micahyy/czmao_WCH/hardware/case/output/print_top.dxf

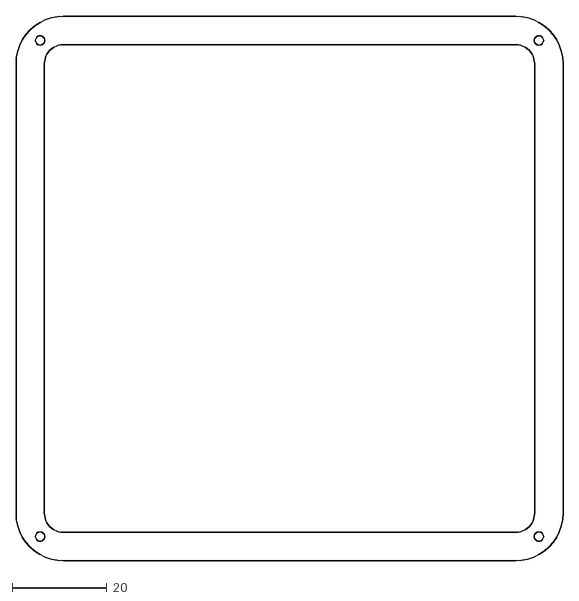
[picture p1: CAD file, 2026-11-12]
hardware/case/output/print_top.dxf
115.7 x 115.2
