micahyy/czmao_WCH/hardware/case/output/cnc_plate.dxf

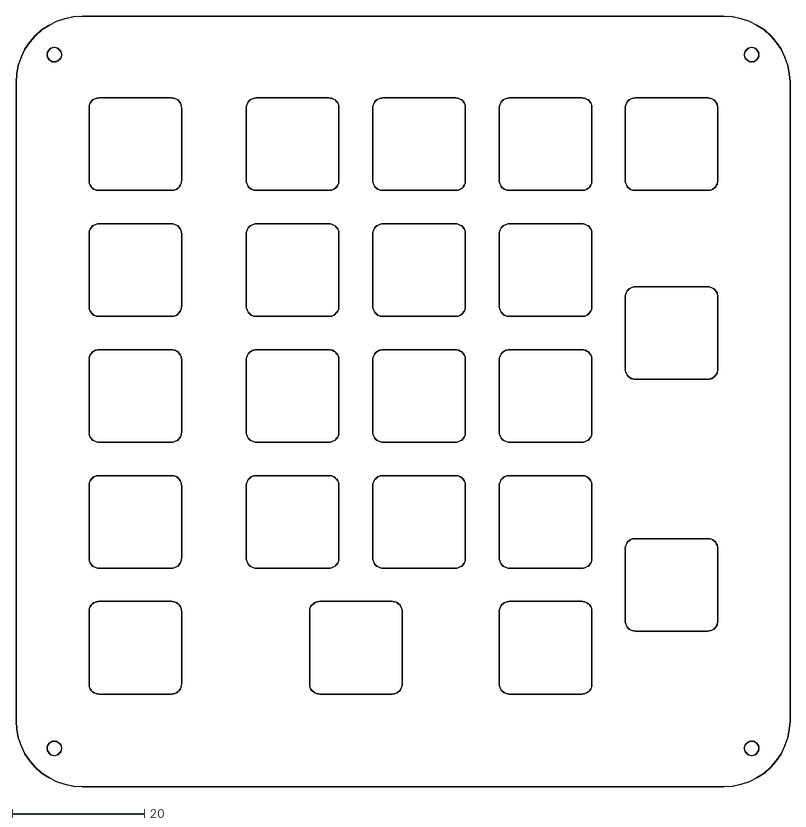
[picture p2: CAD file, 2026-11-12]
hardware/case/output/cnc_plate.dxf
117.1 x 116.6
