micahyy/czmao_WCH/hardware/case/output/cnc_top.dxf

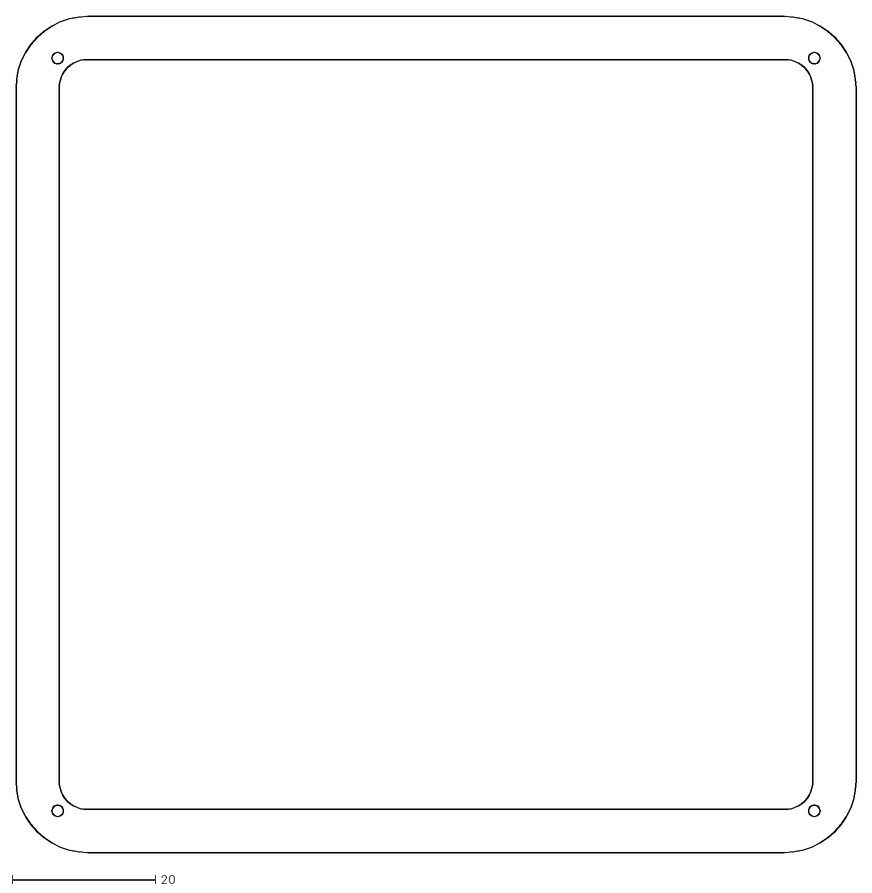
[picture p3: CAD file, 2026-11-12]
hardware/case/output/cnc_top.dxf
117.1 x 116.6
