micahyy/czmao_WCH/hardware/case/output/print_plate.dxf

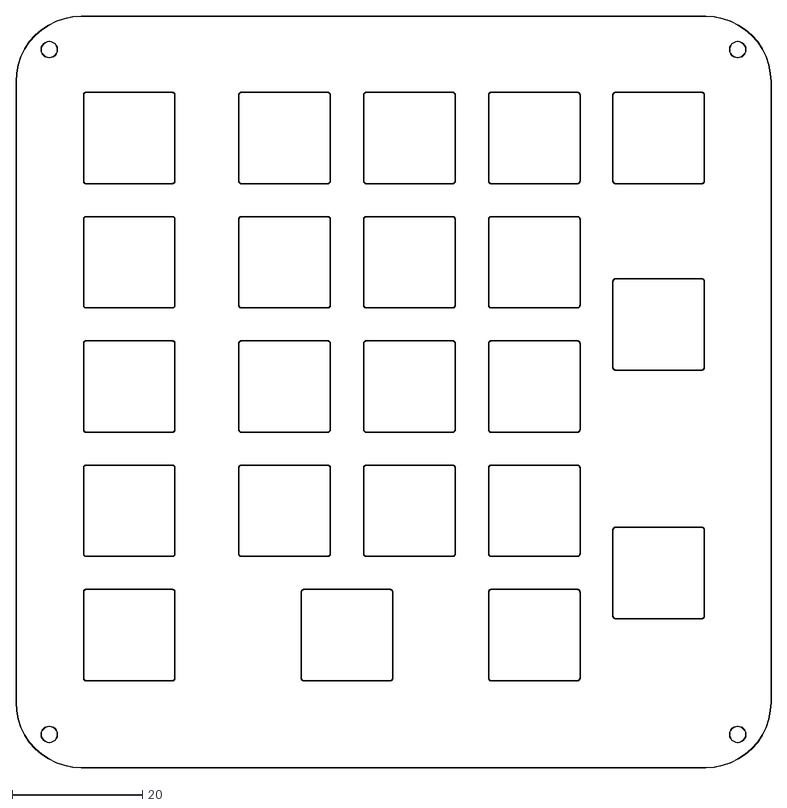
[picture p4: CAD file, 2026-11-12]
hardware/case/output/print_plate.dxf
115.7 x 115.2
