micahyy/czmao_WCH/hardware/pcb/board_data.scad

// 由 tools/extract_step.py 从 STEP 自动提取，勿手工编辑

// 坐标 = STEP 原始坐标(mm)，原点在 PCB 左下角附近；+Y 边是 USB-C 侧

board_t = 1.6000;
board_cx = 49.5301; board_cy = 51.5247;
board_w = 98.5268; board_h = 97.9735;
usb_x = 49.8829; usb_y = 95.7908;
board_poly = [[2.5934,95.2364],[42.4120,95.2375],[42.7620,95.2714],[43.0987,95.3729],[43.4091,95.5381],[43.6813,95.7607],[43.9048,96.0322],[44.0711,96.3420],[44.1737,96.6783],[44.2088,97.0282],[44.2088,100.0762],[44.2172,100.1611],[44.2419,100.2428],[44.2821,100.3180],[44.3363,100.3840],[44.4022,100.4381],[44.4775,100.4784],[44.5592,100.5031],[44.6441,100.5115],[55.3718,100.5115],[55.4685,100.5020],[55.5615,100.4738],[55.6471,100.4280],[55.7222,100.3663],[55.7839,100.2912],[55.8297,100.2055],[55.8579,100.1126],[55.8674,100.0159],[55.8674,97.0282],[55.9018,96.6786],[56.0038,96.3425],[56.1694,96.0328],[56.3922,95.7612],[56.6637,95.5384],[56.9735,95.3728],[57.3096,95.2709],[57.6592,95.2364],[97.0292,95.2364],[97.3734,95.2025],[97.7044,95.1022],[98.0094,94.9391],[98.2768,94.7197],[98.4962,94.4524],[98.6592,94.1473],[98.7596,93.8164],[98.7935,93.4722],[98.7935,2.5380],[0.2667,2.5380],[0.2667,92.9097],[0.3114,93.3636],[0.4438,93.8001],[0.6588,94.2024],[0.9482,94.5550],[1.3008,94.8443],[1.7030,95.0593],[2.1395,95.1917]];
switch_xy = [[9.0170,90.4615],[32.8296,90.4615],[51.9749,90.4615],[71.1201,90.4615],[90.1702,90.4615],[9.0170,71.4114],[32.8296,71.4114],[51.9749,71.4114],[71.1201,71.4114],[90.1702,61.8864],[9.0170,52.3614],[32.8296,52.3614],[51.9749,52.3614],[71.1201,52.3614],[9.0170,33.3114],[32.8294,33.3113],[51.9748,33.3113],[71.1201,33.3113],[90.1702,23.7863],[9.0170,14.2613],[42.4021,14.2613],[71.1201,14.2613]];
switch_refs = ["ESC","NUM","P/","P*","P-","HOME","P7","P8","P9","P+","PGUP","P4","P5","P6","PGDN","P1","P2","P3","PENT","FN","P0","PDOT"];
pcb_holes = [[4.445,9.525,0.840],[4.445,28.575,0.840],[4.445,47.625,0.840],[4.445,66.675,0.840],[4.445,85.725,0.840],[5.715,12.065,1.481],[5.715,31.115,1.481],[5.715,50.165,1.481],[5.715,69.215,1.481],[5.715,88.265,1.481],[9.487,4.488,1.903],[9.487,23.538,1.903],[9.487,42.588,1.903],[9.487,61.638,1.903],[9.487,80.688,1.903],[9.525,9.525,2.069],[9.525,28.575,2.069],[9.525,47.625,2.069],[9.525,66.675,2.069],[9.525,85.725,2.069],[12.065,14.605,1.481],[12.065,33.655,1.481],[12.065,52.705,1.481],[12.065,71.755,1.481],[12.065,90.805,1.481],[14.605,9.525,0.840],[14.605,28.575,0.840],[14.605,47.625,0.840],[14.605,66.675,0.840],[14.605,85.725,0.840],[28.257,28.575,0.840],[28.258,47.625,0.840],[28.258,66.675,0.840],[28.258,85.725,0.840],[29.527,31.115,1.481],[29.528,50.165,1.481],[29.528,69.215,1.481],[29.528,88.265,1.481],[33.299,23.538,1.903],[33.299,42.588,1.903],[33.299,61.638,1.903],[33.299,80.688,1.903],[33.337,28.575,2.069],[33.338,47.625,2.069],[33.338,66.675,2.069],[33.338,85.725,2.069],[35.877,33.655,1.481],[35.878,52.705,1.481],[35.878,71.755,1.481],[35.878,90.805,1.481],[37.830,9.525,0.840],[38.417,28.575,0.840],[38.418,47.625,0.840],[38.418,66.675,0.840],[38.418,85.725,0.840],[39.100,12.065,1.481],[42.910,9.525,2.069],[43.000,4.488,1.903],[45.450,14.605,1.481],[47.403,28.575,0.840],[47.403,47.625,0.840],[47.403,66.675,0.840],[47.403,85.725,0.840],[47.990,9.525,0.840],[48.673,31.115,1.481],[48.673,50.165,1.481],[48.673,69.215,1.481],[48.673,88.265,1.481],[52.413,23.538,1.903],[52.413,42.588,1.903],[52.413,61.638,1.903],[52.446,80.688,1.903],[52.483,28.575,2.069],[52.483,47.625,2.069],[52.483,66.675,2.069],[52.483,85.725,2.069],[55.023,33.655,1.481],[55.023,52.705,1.481],[55.023,71.755,1.481],[55.023,90.805,1.481],[57.563,28.575,0.840],[57.563,47.625,0.840],[57.563,66.675,0.840],[57.563,85.725,0.840],[66.548,9.525,0.840],[66.548,28.575,0.840],[66.548,47.625,0.840],[66.548,66.675,0.840],[66.548,85.725,0.840],[67.818,12.065,1.481],[67.818,31.115,1.481],[67.818,50.165,1.481],[67.818,69.215,1.481],[67.818,88.265,1.481],[71.590,4.488,1.903],[71.590,23.538,1.903],[71.590,42.588,1.903],[71.590,61.638,1.903],[71.590,80.688,1.903],[71.628,9.525,2.069],[71.628,28.575,2.069],[71.628,47.625,2.069],[71.628,66.675,2.069],[71.628,85.725,2.069],[74.168,14.605,1.481],[74.168,33.655,1.481],[74.168,52.705,1.481],[74.168,71.755,1.481],[74.168,90.805,1.481],[76.708,9.525,0.840],[76.708,28.575,0.840],[76.708,47.625,0.840],[76.708,66.675,0.840],[76.708,85.725,0.840],[85.598,19.050,0.840],[85.598,57.150,0.840],[85.598,85.725,0.840],[86.868,21.590,1.481],[86.868,59.690,1.481],[86.868,88.265,1.481],[90.640,52.113,1.903],[90.640,80.688,1.903],[90.678,13.970,1.903],[90.678,19.050,2.069],[90.678,57.150,2.069],[90.678,85.725,2.069],[93.218,24.130,1.481],[93.218,62.230,1.481],[93.218,90.805,1.481],[95.758,19.050,0.840],[95.758,57.150,0.840],[95.758,85.725,0.840]];
