micahyy/czmao_WCH/hardware/pcb/ch552g_22key/config_ch552t.h

#pragma once
/* ============================================================================
 * CH552T (TSSOP20) x 22 键 numpad —— IO 分配 v0.1  [备选方案]
 *
 * 与同目录 config.h (CH552G/SOP16) 二选一：把选中的文件复制成
 * keyboards/<你的板>/config.h 即可。两份 DIODE_DIRECTION 都是 COL2ROW，
 * 但 ROW/COL 引脚宏不同（G 版 10 个 GPIO、T 版 14 个），别混用。
 *
 * ⚠ 档案状态（19:44 更新）：本文件是 11-08 下单前的硬件推理链，**不参与编译**。
 *   最终出货配置在 ../../firmware/keyboards/DS22Lite/config.h：
 *   VID 0x5262 / PID 0x4443，USB 产品串 DS22Lite；
 *   砍掉宏 + TAP_DANCE + FCODE_TO_MOUSE；2 层动态（VIA 可改）+ 2 层静态
 *   （Flash 常量，VIA 看不到）共 4 套键位；DataFlash 只用 106B / 128B，
 *   VIA_MAGIC_CODE = 0x5C。
 *   本文件里遗留的单层、VID 0xFEED、Tap Dance、17B 宏分区等结论均已作废。
 *
 * 为什么有这份：老板进货价 CH552G ¥1.57 / CH552T ¥1.75，差价仅 ¥0.18。
 * 为省 0.18 去把 RST 改造成矩阵输入（要改 framework 三处 + 加外部上拉 +
 * 守 En_RST_RESET 产线红线）不划算，直接换 T 版是零固件改动。
 *
 * ★ 20:07 已按 Netlist_DS22Lite_R1.0.0 全量同步（老板「下单」）：
 *   ROW = {P3.3,P3.4,P3.5,P1.3,P1.2} / COL = {P3.2,P1.4,P1.5,P1.6,P1.7}，
 *   灯 2812_PWM = P1.0，P3.0/P3.1/P1.1 空置，板上无编码器 → 编码器宏已关。
 *   BAT54C 共阴极接 ROW → DIODE_DIRECTION = COL2ROW（行输出拉低、列输入上拉）。
 *   keymap.h 两层键表 / RGB_CONFIG / DS22Lite_via.json 的 (r,c) 已同步重排。
 *   旧的 RP17 基线（灯 P3.5、编码器 P1.2/P1.3）与 19:08 TODO 警告一并作废。
 *
 * 引脚编号规则（沿用框架）：两位数 = 端口*10 + 位号
 *   32 = P3.2    14 = P1.4    35 = P3.5    10 = P1.0    12 = P1.2 ...
 *
 * ---------------------------------------------------------------------------
 * TSSOP20 引脚（WCH CH552DS1 第 4 节 / LCSC C111367）
 *
 *  pin   PORT        用途              备注
 *   1    P3.2        COL0              BAT54C 阳极侧，芯片直连
 *   2    P1.4        COL1
 *   3    P1.5        COL2              G 版同一端口
 *   4    P1.6        COL3
 *   5    P1.7        COL4
 *   6    RST         NC                彻底不引出，见清单第 8 条
 *   7    P1.0        WS2812 DI         ★ 20:07 改：网表 2812_PWM
 *   8    P1.1        空置               G 版在 pin9 作 ROW4
 *   9    P3.1        空置               G 版在 pin7 作 COL1
 *  10    P3.0        空置               G 版在 pin8 作 COL0
 *  11    P3.3        ROW0              BAT54C 共阴极侧
 *  12    P3.4        ROW1
 *  13    P3.5        ROW2              ★ T 版新增（G 版未引出）
 *  14    P3.6 / UDP  D+                USB 专用，不可占用
 *  15    P3.7 / UDM  D-                USB 专用，不可占用
 *  16    P1.3 / XO   ROW3              ★ 不接晶振才有此脚
 *  17    P1.2 / XI   ROW4              ★ 不接晶振才有此脚
 *  18    GND         --                G 版在 pin14
 *  19    VCC         5V                烧录 Flash 必须 5V；G 版在 pin15
 *  20    V33         3.3V              内置 LDO 输出，必须 100nF 去耦，禁与 VCC 短接
 *
 *  ★ 20:07 更正：DS22Lite 的 ROW/COL 网络与 RP17 基线**不是同一组端口**
 *    （不只是封装脚号重排），矩阵宏必须按网表整组换，见下方矩阵块。
 *
 *  GPIO 账（不接晶振）：P1 八位 + P3 八位 = 16，减 USB 的 P3.6/P3.7 = 14。
 *    矩阵 5+5 = 10  +  WS2812 1 = 11，剩 P3.0/P3.1/P1.1 三个空置。
 *    板上没有编码器，P1.2/P1.3 已改作 ROW4/ROW3。
 *    一旦在 XI/XO 上接晶振，P1.2/P1.3 就没了，掉回 12 个 IO（本板不接）。
 * ==========================================================================*/

#define VENDOR_ID   0xFEED    // QMK 社区通用占位 VID；出货前换自己的，DS22Lite_via.json 必须同步
#define PRODUCT_ID  0x0016    // 同一 VID 下不可重复；出货前确认未占用
#define MANUFACTURER 'M','a','i','k','u'   // TODO 出货前确认品牌字符串
#define PRODUCT      'D','S','2','2','L','i','t','e'       // 与 DS22Lite_via.json 的 name 一致

/* ---- 矩阵：20:07 按 DS22Lite_R1.0.0 网表钉死 -----------------------------
 * 下标 0..4 必须与 keymap.h / DS22Lite_via.json 的 (r,c) 一一对应：
 *   row0=P3.3 row1=P3.4 row2=P3.5 row3=P1.3 row4=P1.2 （BAT54C 共阴极侧）
 *   col0=P3.2 col1=P1.4 col2=P1.5 col3=P1.6 col4=P1.7 （芯片直连侧）
 * 二极管 pin3 共阴极全接 ROW，阳极经开关接 COL → 电流只能 COL→ROW，
 * 故 COL 是输入上拉侧、ROW 是输出拉低侧 = COL2ROW。 */
#define MATRIX_ROWS     5
#define MATRIX_COLS     5
#define MATRIX_ROW_PINS { 33, 34, 35, 13, 12 }
#define MATRIX_COL_PINS { 32, 14, 15, 16, 17 }
#define DIODE_DIRECTION COL2ROW
/* 扫描极性（已逐字核框架 src/qmk/quantum/matrix.c）：
 *   COL2ROW = 行输出拉低选通、列输入上拉读取（本板）
 *   ROW2COL = 列输出拉低选通、行输入上拉读取
 * 输入侧永远是「被读」的那一组，内部上拉自动跟着走，外部 10k 不用画。 */

/* ---- 功能开关 ------------------------------------------------------------ */
/* ROM 14336B：基础 9011B，余 5325B。开 RGB 约 2768B + 编码器/按键控灯
 * 约 404B 后还剩 ~2.1KB，宏和鼠标功能不用砍。
 * ⚠ RAM 只有 266B：22 颗 WS2812 的帧缓冲就要 66B，全灯效是否撑得住
 *   必须上实板验，别只看 ROM 余量。
 * ★ DataFlash 128B 精算（本版开 RGB+编码器，config_end = 1+5+5 = 11）：
 *   双层: 11 + keymap 100 + encoder 8 + tapdance 12 = 131 > 127 -> macro = -3B，
 *         会越界写 EEPROM（运行时诡异 bug，编译不一定报错），绝对不能开。
 *   单层: 11 + keymap  50 + encoder 4 + tapdance 12 =  77 -> macro = 51B，安全。
 *   所以本版强制单层；keymap.h 用 #ifdef 自动适配，不用手改。 */
// #define TWO_LAYER_ENABLE
#define TAP_DANCE_ENABLE
#define TAP_DANCE_COUNT  2
#define TAPPING_TERM     200
#define EXTRAKEY_ENABLE
#define MOUSE_ENABLE
#define FCODE_TO_MOUSE_ENABLE
#define DIAL_ENABLE           // 404B，G 版放不下，T 版可开

/* ---- 灯：T 版可全开，也可做出货/开源两种贴法 ---------------------------- */
/* WS2812_DI_PIN 用框架编码（端口*10 + 位号）：10 = P1.0 / TSSOP20 pin7，
 * 不是封装脚号，别和 pin10(P3.0) 混。20:07 由 35(P3.5) 改过来 —— 网表
 * 里 2812_PWM 接 P1.0，而 P3.5 已被 ROW2 占用，再共用会打架。
 * 选脚依据（已核 src/qmk/quantum/rgb_matrix/rgb_matrix_drivers.c）：
 * ws2812_flush() 按 WS2812_DI_PIN 选 neopixel_show_Px_y()，CH55xduino 的
 * WS2812 库为 P1.0~P1.7 / P3.0~P3.7 共 16 个脚各写了一份时序函数，
 * 属软件 bit-bang、不依赖 SPI/PWM 硬件 → 换脚只改这个宏，不用写驱动。
 * 官方板实证：NRGB 用 16(P1.6)、RP17/KeyKey 用 15(P1.5)，脚并不固定。
 * 别选 36/37（USB D+/D-），也别选矩阵已占的 10 个脚。 */
#define RGB_MATRIX_ENABLE
#define WS2812_DI_PIN        10          // P1.0 / TSSOP20 pin7；网表 2812_PWM
#define RGB_MATRIX_LED_COUNT 22
#define RGB_EFFECTS_PLUS
#define RGB_KEY_CONTROL
/* 同一块 PCB 出两个 SKU：开源散件不贴灯珠与 WS2812 相关料，出货版全贴。
 * 固件若按无灯编译，把上面五个宏注释掉即可，其余不用动。 */

/* ---- 编码器：20:07 关闭，DS22Lite 板上没有 EC11 --------------------------
 * P1.2/P1.3 已被 ROW4/ROW3 占用，开着会与矩阵抢脚。keymap.h 里的
 * ENCODER_MAP 无条件定义，dynamic_keymap.c 由 #ifdef ENCODER_ENABLE 包住，
 * 关掉后不占 DataFlash，不用删。 */
// #define ENCODER_ENABLE
// #define NUM_ENCODERS    1
// #define ENCODERS_PAD_A  { 12 }
// #define ENCODERS_PAD_B  { 13 }

/* ============================================================================
 * 硬件检查清单（相对 G 版的差异 + 共有项）
 *
 *  1. VCC(pin19)=5V、V33(pin20)=3.3V 各一颗 0.1uF 靠近引脚，禁短接。
 *     GND 是 pin18。3.3V 单供能跑但写不了 Flash —— 手贴实验板最容易踩。
 *     ⚠ 19:50 网表核查：C1 + C55~58 全挂 VBUS_5V，V33 一颗都没有，
 *       下单前必须补 0603 100nF 到 pin20-GND（依据见 6b 条）。
 *  2. 免晶振：XI/XO (pin17/16) 已改作 ROW4/ROW3，绝对不要接晶体或负载电容。
 *     内置 24MHz RC + USB SOF 校准，V33 退耦是枚举稳不稳的命门。
 *  3. USB：D+/D- 直连 P3.6/P3.7，手册要求这两根线不串电阻。
 *     ★ D+ 的 1.5k 上拉是芯片内部集成的（USB_CTRL 的 bUC_DEV_PU_EN，
 *       复位值 0，固件枚举时软件使能），**外部不要画常驻 1.5k**。
 *       常驻外部上拉的真正后果是「每次上电都被判成进烧录模式、用户
 *       程序不跑」（WCH 论坛实证卡 60 秒），不只是阻抗问题；19:26 更正。
 *       19:08 更正：旧注释照 STM32 通用做法写「D+ 1.5k 上拉到 3.3V」，
 *       对 CH552 是错的。
 *     ── 19:32 补（老板追问「内部有 1.5k 上拉还有 15k 下拉？」）：手册 10.2
 *        原话「P3.6 和 P3.7 可选标准上拉电阻(到 V33)、**15KΩ 下拉电阻**、
 *        或为其中一引脚提供 1.5KΩ 强上拉电阻(到 V33)」，且「1.5KΩ 强上拉
 *        电阻**优先于**下拉电阻」。芯片内部这两颗挂在同一对脚上，但分属
 *        两种 USB 角色、不会同时生效：15k 下拉给 Host 模式检测下游设备用，
 *        1.5k 上拉给 Device 全速识别用。
 *        `UDEV_CTRL` 复位值 10xx 0000b → bit7 `bUD_PD_DIS`=1，
 *        **上电默认禁用内部下拉**；框架 `USBDeviceCfg()` 里还有
 *        `UDEV_CTRL = bUD_PD_DIS; // Disable DP/DM pull-down resistor`
 *        再关一次（双保险），做 Device 键盘时它全程不生效。
 *        另：主机(PC/Hub)端口 D+/D- 各有一颗 15k 下拉到 GND，是 USB 2.0
 *        规范强制、永远在、**不在本板上** —— 下面分压算的始终是它。
 *     Type-C 的 CC1/CC2 各 5.1k 下拉（原理图 R1/R2 已有）。
 *  4. 进 boot（口语叫 DFU，实为出厂 bootloader 的 ISP 模式，厂商类
 *     0xFF / VID 4348 / PID 55E0）：出厂默认 P3.6(D+) 上电为高触发，
 *     配置位一个字都别改。原理图缺的就是这条回路：
 *       VDD_3.3V(V33) -> 5.1k(0603) -> 短接焊盘(两裸盘, 默认断开) -> D+
 *     顺序：断电 -> 短接 -> 插 USB 上电 -> 松开短接 -> 工具识别 -> 下载。
 *     ★ 上电后必须松开，D+ 是数据线，强上拉一直挂着 USB 没法通讯。
 *     15k~33k 下拉防误触发建议 DNP（留 0603 位不贴）：短接平时断开本
 *     就不会误触发；真贴 33k，下拉变成 15k(主机)||33k ≈ 10.3k，
 *     5.1k 上拉时 D+ 只剩 ≈ 2.21V，余量变小且常态把 D+ 拉低，不值。
 *     （19:26 更正：旧注释按 10k+33k 算出 2.5V，漏算了主机 15k 下拉。）
 *     产线统一走 USB，别用串口 ISP（SOP 已定，少一个变量）。
 *     ── 19:22 追问「这颗 10k 能不能取 5V」：**不能，只取 V33(3.3V)**。
 *       1) 手册第 4 节引脚表脚注原话「P3.6 和 P3.7 内部使用 V33 作为
 *          I/O 电源，其输入输出的高电平只能到 V33 电压，不支持 5V」。
 *          5V 经 ESD 管倒灌会顶高 V33，而内置 24MHz RC 正由 V33 供电
 *          （第 2 条）→ 枚举不稳甚至过压损伤。
 *       2) USB 2.0 全速 D+/D- 是 3.3V 逻辑：输出高 2.8~3.6V、上限 3.6V，
 *          识别上拉规范 3.0~3.6V(典型 3.3V)；5V 越界，且 D+ 直连主机 PHY。
 *       3) 参考设计一律 3.3V：LCDWiki 最小系统板 R1 经 SW1 上拉 3.3V、
 *          Blinkinlabs CH55x Reset Controller 10k/3.3V、WCH 例程 V33 短 P3.6。
 *     ── 19:26 定稿：阻值改 **5.1k**（与 CC1/CC2 下拉共用同一盘 0603，
 *        少一种物料）。按主机端 15k 下拉估算（工程估算非手册规格）：
 *        5.1k → D+ ≈ 3.3x15/20.1 ≈ 2.46V，比 10k 的 2.0V 余量更足；
 *        V33 带 5.1k 约 0.16mA 无压力。别另加 LDO，也别用 5V 分压
 *        （分压网络并进 D+ 会改变电平）。
 *        ★ 19:32 核算：只算主机那颗 15k 是有依据的 —— 芯片内部 15k
 *          下拉复位即禁用；万一它没关掉，15k||15k = 7.5k，5.1k 上拉
 *          只剩 3.3x7.5/12.6 ≈ 1.96V，触发余量就悬了。
 *     ── 19:26 追问「内部已有 1.5k，为啥还要外加，不重复么」：**不重复**。
 *        手册 16.2 `USB_CTRL` 表：`bUC_DEV_PU_EN`(bit5) **复位值 0**，
 *        「该位为 1 则使能 USB 设备传输并且启用内部上拉电阻」；
 *        `bUC_SYS_CTRL1/0 = 00` 即「禁止 USB 设备功能，关闭内部上拉」。
 *        所以上电复位那一刻芯片内部两颗都是**断开**的（1.5k 上拉
 *        `bUC_DEV_PU_EN` 复位 0；内部 15k 下拉 `bUD_PD_DIS` 复位 1 禁用），
 *        D+ 上真正生效的只有**主机侧那颗 15k 下拉**（低电平），bootloader
 *        想读到「1」只能靠外面这颗临时上拉。19:32 更正：旧写「只剩主机
 *        15k」没交代芯片内部还有一颗，容易被误读成漏算。
 *        采样完之后才由软件置位打开内部 1.5k —— 进下载模式是 bootloader
 *        自己开，跳去跑固件则是 `USBDeviceCfg()` 里
 *        `USB_CTRL |= bUC_DEV_PU_EN`（已核框架源码）。两个窗口不重叠。
 *        WCH 官方论坛 TECH29 原话「芯片上电瞬间检测 D+ 引脚是否是高电平，
 *        以此进入烧录模式」「不需要下载就不要增加该上拉」；论坛那个
 *        「每次上电卡烧录模式 60 秒」的故障，正是把 D+ 做成**常驻上拉**
 *        让两颗并存 —— 这才是第 3 条「外部别画常驻 1.5k」的真正原因。
 *        手册「D+/D- 不能串电阻」指数据通路串联，这颗 5.1k 是并联，不冲突；
 *        用 5.1k 弱上拉而非硬短 V33，是为了让主机仍能驱动 D+。
 *     RST(pin6) 彻底 NC，不引出任何东西：不接复位按键、不接上下拉、
 *     不留测试点、不连任何网络；芯片贴片焊盘照留但悬空不铺铜。18:55 定稿。
 *     出厂 En_RST_RESET=0，内置下拉保证常态低电平；热复位从 0 地址跑
 *     用户程序、进不了 0x3800 的 bootloader，按键无用。彻底悬空后连
 *     「误勾使能 RST Pin 会变砖」这条红线也自动消失（脚始终为低）。
 *  5. 二极管：每键 1 颗。BAT54C 共阴极双管，**阴极接输出侧**；本板
 *     COL2ROW → 输出侧是行线，故 pin3 共阴极接 ROW，同行两键共用一颗。
 *     网表实证：12 颗 BAT54C 的 pin3 全接 {P3.3,P3.4,P3.5,P1.3,P1.2}，
 *     两阳极经开关接 COL。若整组翻回 ROW2COL，阴极要改接列线。
 *     ── 20:07 按网表实算：共阴极按 ROW 分组，每行键数 5/4/5/4/4，
 *        每行 ceil(n/2) 颗 = 3+2+3+2+2 = **12 颗 BAT54C / 0.36 元**，
 *        36 个 SOT-23 焊点；D71/D72 各空一个阳极属正常。
 *        （18:59 旧精算按列分组得 13 颗，是 ROW2COL 假设下的数，作废。）
 *     ── direct pin 要 22 个独立 GPIO 且 keymap/VIA 矩阵维度要重排，
 *        G 版 10 / 本版 14 都不够；换够脚的芯片，主控差价够买十板二极管。
 *     ── 可选砍掉全部二极管：框架 matrix.c 的 matrix_scan() 只有扫描 +
 *        debounce()、**没有 ghost 屏蔽**（DIODE_DIRECTION 不定义直接 #error），
 *        3 键成 2x2 矩形会真的上报幽灵键，不是降级 6KRO；要砍须自己加
 *        阻塞式检测，且不能标 NKRO。2 键同按永远安全（鬼影最少 3 键）。
 *  6. ★ 20:05 更正：外部 10k 上拉**不需要**，网表里也不用画。框架
 *     `matrix_init_pins()` 把 10 个矩阵脚全设 `setPinInputHigh_atomic()`
 *     = writePinHigh + pinMode(INPUT_PULLUP)，只有选通那一瞬才切
 *     `setPinOutput_writeLow()`，读完立刻恢复上拉，输入线不会浮空。
 *     硬依据：gpio.h 的 `setPinInputHigh(pin) -> pinMode(pin,INPUT_PULLUP)`；
 *     ch55xduino `wiring_digital.c` 里 INPUT_PULLUP = Pn_MOD_OC|=1 /
 *     Pn_DIR_PU|=1，按 CH552DS1 表 10.2.2 是「准双向模式…引脚有上拉
 *     电阻」（两寄存器复位值 FFh，上电本来就是这个模式），只有 INPUT(00)
 *     才是高阻无上拉。作者还留了 waitInputPinDelay()=10us /
 *     MATRIX_IO_DELAY=30us 专门等弱上拉回升，可见整份框架按内部上拉设计。
 *     ── 旧说法「外部 10k 上拉留在输入侧」是套普通 MCU 的保守习惯，作废。
 *     真要补（长走线 / 强干扰 / 换不带内部上拉的主控）：加在**输入侧**，
 *     ROW2COL 是行线、COL2ROW 是列线，0603 10k 上拉到 **VBUS_5V**
 *     （P1/P3 除 P3.6/P3.7 外都随 VCC=5V；只有 USB 两脚是 V33 域），
 *     别拉到 V33。肖特基反向漏电比 1N4148 大、高温更明显，这条仍成立。
 *  6b. **V33(pin20) 必须单独一颗 0603 100nF 到 GND，靠脚放**。V33 是
 *      内部 5V→3.3V LDO 的输出，内核 / USB PHY / 内置 24MHz RC 全吃这路
 *      电；这颗电容是给 LDO 稳环路 + 瞬态退耦的，跟 boot 短接贴不贴、
 *      跟进不进 ISP 完全无关。手册第 4/7.1 节「必须外接不小于 0.1uF」，
 *      缺了影响枚举稳定性、热插拔、温漂与批量一致性（RC 靠 USB SOF
 *      校准，纹波大会频率失准掉线）。当前网表 C1 + C55~58 全挂
 *      VBUS_5V，V33 一颗都没有 —— 已列入补件。加了不影响救砖：100nF
 *      充电 µs 级，采样在复位释放之后；R3 5.1k 只从 V33 取 0.16mA。
 *  7. 阻容统一 0603；灯珠封装定 WS2812-5050（有侧面焊盘可拖焊），
 *     别用 3535 MINI。TSSOP20 是 0.65mm pitch，手贴可拖焊，比 SOP16 难一档。
 *  8. 灯线与供电：手册只把 P3.6/P3.7 单列为「内部用 V33 作 I/O 电源、
 *     高电平只能到 V33、不支持 5V」的特例，其余 GPIO 随 VCC；本板 VCC=5V，
 *     故 P3.5 是 5V 逻辑，可直推 5V 供电的 WS2812，不用加电平转换。
 *     ★ 18:49 定：P3.5 → 第一颗灯 DIN 走线仅 22mm，**不串电阻，直连**。
 *       每颗灯 VDD 旁 100nF 保留（去耦，与串阻无关）。
 *       依据：串阻不是限流(DIN 是 uA 级 CMOS 输入)，只为阻尼传输线反射、
 *       抑制 ESD/热插拔浪涌、防止灯珠无电时数据线经 ESD 管反向供电。
 *       而这三条在本板全不成立：22mm 在 FR4 上单程约 0.13ns，远小于 GPIO
 *       上升沿(数 ns)，属集总参数不产生反射；DIN 是板内走线、不外接连接器，
 *       灯珠焊死不可热插拔；灯珠与 MCU 同用 USB 5V，不存在单边供电。
 *       （18:45 曾定 330Ω，走线 22mm 这个数出来后作废。）
 *       可选保险：layout 留一个 0603 串联位，**默认贴 0Ω 才导通**；实测若
 *       第一颗灯颜色漂移/闪烁，改贴 100~330Ω 即可，不用改板。不留位就
 *       纯直连，出问题只能割线飞线。
 *       若日后改成外接灯带(>150mm 散线)或灯珠独立供电，按 100~220Ω /
 *       220~470Ω 加回；>1kΩ 会吃掉 800kbps 时序裕量(DIN 约 30pF，
 *       每 bit 1.25us、0 码高电平 0.4us、容差 ±150ns)。后面每级 DOUT
 *       会整形再生信号，不用逐颗串。
 *     ★ 电流按实际灯珠规格 2.5mA/颗算：22 x 2.5 = 55mA，加 CH552 本体与
 *       矩阵扫描，整板约 100mA 以内。USB 2.0 枚举前 100mA / 配置后 500mA
 *       都够，上电灯全亮也不会过流 —— 不需要固件限亮度、不需要限流代码、
 *       不需要 1000uF 大电解，灯效可以全开，ROM/RAM 也松一档。
 *       （18:40 曾写「50mA/颗 → 1.1A 会过流」，那是套通用 WS2812B 全白
 *         满亮理论峰值 20mA x 3 通道 = 60mA/颗，对本板用料不成立，作废。）
 *       记号：若 2.5mA 是静态电流或单通道值而非整颗工作电流，全白峰值
 *       按规格书 / 实测另核；以实际料的规格为准。
 *
 * ---------------------------------------------------------------------------
 * 布线时的调整规则
 *
 *  a) P1.0(pin7) 已给 WS2812 DIN；空置的是 P3.0/P3.1/P1.1 三个，可留测试点，
 *     别再挪作矩阵。
 *  b) 改脚只动 MATRIX_ROW_PINS / MATRIX_COL_PINS 两个宏（本文件是唯一
 *     改脚处）。组内顺序任意、行列整组可互换、也可改 4x6，10 个 GPIO
 *     任意分配 —— 纯软件 GPIO 扫描，不绑硬件外设。每次改必须同步动：
 *       1) 整组互换 -> DIODE_DIRECTION 翻；二极管极性跟着翻（见第 5 条）；
 *          输入侧随之从行线变列线（内部上拉自动跟着走，外部 10k 不需要，
 *          见第 6 条）。
 *       2) 组内重排 -> keymap.h 两层键表、DS22Lite_via.json 的 layout "r,c"
 *          坐标、3 个 KC_NO 位置全跟着换，否则 VIA 里点 A 改到 B。
 *       3) 改矩阵形状 -> 连同 VIA json 的 matrix 行列数与 layout 全改。
 *       4) 不能动的脚：P3.6/P3.7(USB D+/D-)、RST(pin6, 已彻底 NC 不引出)、
 *          电源脚。本版 P1.0 已给 WS2812，P3.5/P1.2/P1.3 都是矩阵行线；
 *          要与矩阵脚对调必须同步改 WS2812_DI_PIN。
 *          P1.2/P1.3 是 XI/XO，前提永远是不接晶振。
 *       5) 宏里是「端口x10 + 位号」不是封装脚号，PCB 按上方 TSSOP20
 *          脚号表连线；G 版端口名相同、封装脚号不同。
 *  c) keymap.h（5x5 / 3 个 KC_NO）与 DS22Lite_via.json（matrix 5/5）已于 20:07
 *     按网表电气矩阵重排完毕；改脚时只同步它们的行列顺序，不用再补键位。
 *  d) 若最终出货版确定无灯无旋钮，可退回 G 版 config.h，但那是另一套
 *     footprint，PCB 不能共用 —— 想一套板通吃两个 SKU 就用本文件。
 * ==========================================================================*/
