micahyy/czmao_WCH/firmware/src/qmk/quantum/quantum.c

/* Copyright 2016-2017 Jack Humbert
 *
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
 * You should have received a copy of the GNU General Public License
 * along with this program.  If not, see <http://www.gnu.org/licenses/>.
 */

#include "quantum.h"

__data uint8_t current_layer = 0, layer_store = 0;

#ifdef TWO_LAYER_ENABLE
void layer_switch(uint16_t keycode, keyrecord_t *record) {
    if (record->event.pressed) {
        switch (keycode) {
            case KC_TO_0: current_layer = 0; break;
            case KC_TO_1: current_layer = 1; break;
            case KC_MO_0: layer_store = current_layer; current_layer = 0; break;
            case KC_MO_1: layer_store = current_layer; current_layer = 1; break;
            /* 静态层入口，键表在 Flash（见 dynamic_keymap.c） */
            case KC_TO_2: current_layer = 2; break;
            case KC_TO_3: current_layer = 3; break;
            case KC_MO_2: layer_store = current_layer; current_layer = 2; break;
            case KC_MO_3: layer_store = current_layer; current_layer = 3; break;
            default: break;
        }
    } else {
        if (keycode == KC_MO_0 || keycode == KC_MO_1 ||
            keycode == KC_MO_2 || keycode == KC_MO_3) {
            current_layer = layer_store;
        }
    }
}
#endif // TWO_LAYER_ENABLE

#ifdef DIAL_ENABLE
void process_dial_key(uint16_t keycode, keyrecord_t *record) {
    if (record->event.pressed) {
        add_dial_key(keycode);
    } else {
        del_dial_key(keycode);
    }
    send_dial_report();
}
#endif

/* Core keycode function, hands off handling to other functions,
    then processes internal quantum keycodes, and then processes
    ACTIONs.                                                      */
bool process_record_quantum(keyrecord_t *record) {
    uint16_t keycode = keymap_key_to_keycode(record->event.key);

#ifdef TWO_LAYER_ENABLE
    /* TO(2)/TO(3)/MO(2)/MO(3) 追加在枚举末尾，是第二段连续区间，
     * 不能只写一个 <= KC_MO_3 的范围（中间隔着 TD/RGB 键码）。 */
    if ((keycode >= KC_TO_0 && keycode <= KC_MO_1) ||
        (keycode >= KC_TO_2 && keycode <= KC_MO_3)) {
        layer_switch(keycode, record);
        return false;
    }
#endif // TWO_LAYER_ENABLE

#ifdef TAP_DANCE_ENABLE
    if (process_tap_dance(keycode, record) == false) {
        return false;
    }
#endif // TAP_DANCE_ENABLE

#ifdef DIAL_ENABLE
    if (keycode >= DIAL_CCW && keycode <= DIAL_CW) {
        process_dial_key(keycode, record);
        return false;
    }
#endif // DIAL_ENABLE

    if (process_record_via(keycode, record) == false) {
        return false;
    }

#if defined(RGB_EFFECTS_PLUS) && defined(RGB_MATRIX_ENABLE) && defined(RGB_KEY_CONTROL)
    if (process_rgb_matrix(keycode, record) == false) {
        return false;
    }
#endif
    
    return true;
}

// void usb_send_for_debug(uint8_t v1, uint8_t v2)
// {
//     report_keyboard_t report1;
//     report1.keys[0] = 0x1E + v1;
//     report1.keys[1] = v2;
//     host_keyboard_send(&report1);
//     report1.keys[0] = 0x00;
//     report1.keys[1] = 0x00;
//     host_keyboard_send(&report1);
// }
