micahyy/czmao_WCH/(commit log)

2026-11-13 chore: remove early board draft files from the public archive
2026-11-13 Build: declare boards in boards.json and select with --board
